UBIEEE/FrankenMouse/hardware/mouse_v3/cad/README.md

# MicroMouse v3 CAD

Version 3 CAD files are hosted on OnShape [here](https://cad.onshape.com/documents/af6c3d153a48b04e15596561/w/45876cc96303d29a7562e9dc/e/812e529ec357d4b21b92344f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)
