UBIEEE/FrankenMouse/hardware/mouse_v2/cad/README.md

# MicroMouse v2 CAD

Version 2 CAD files are hosted on OnShape [here](https://cad.onshape.com/documents/abafea81b596ad090b5c0efe/w/ced7ecb2f8934ecdedd5f346/e/1f72ba2e5dd2ff6e9ada31ef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)
