UBIEEE/FrankenMouse/media/mouse_v3/top_portrait.jpeg

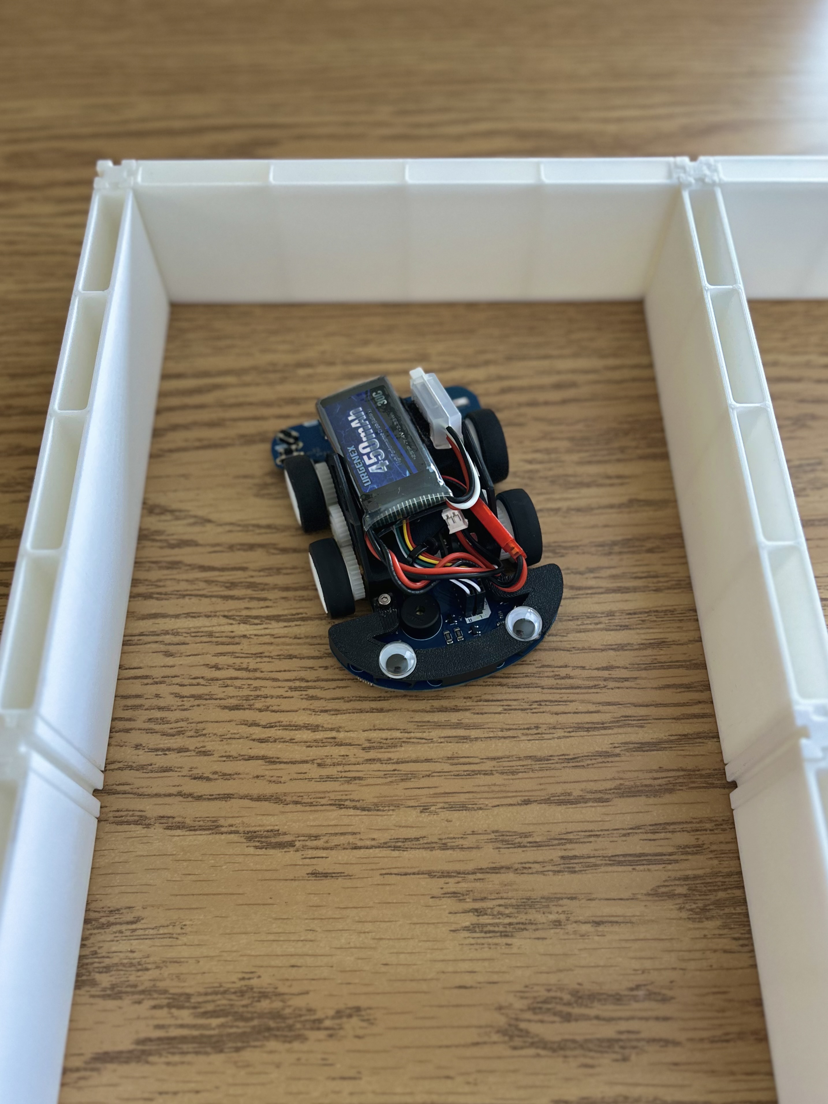
media/mouse_v3/top_portrait.jpeg
