UBIEEE/FrankenMouse/hardware/mouse_v3/pcb/micromouse.kicad_pcb

## KiCad design hardware/mouse_v3/pcb/micromouse.kicad_pcb (2025-03-24)

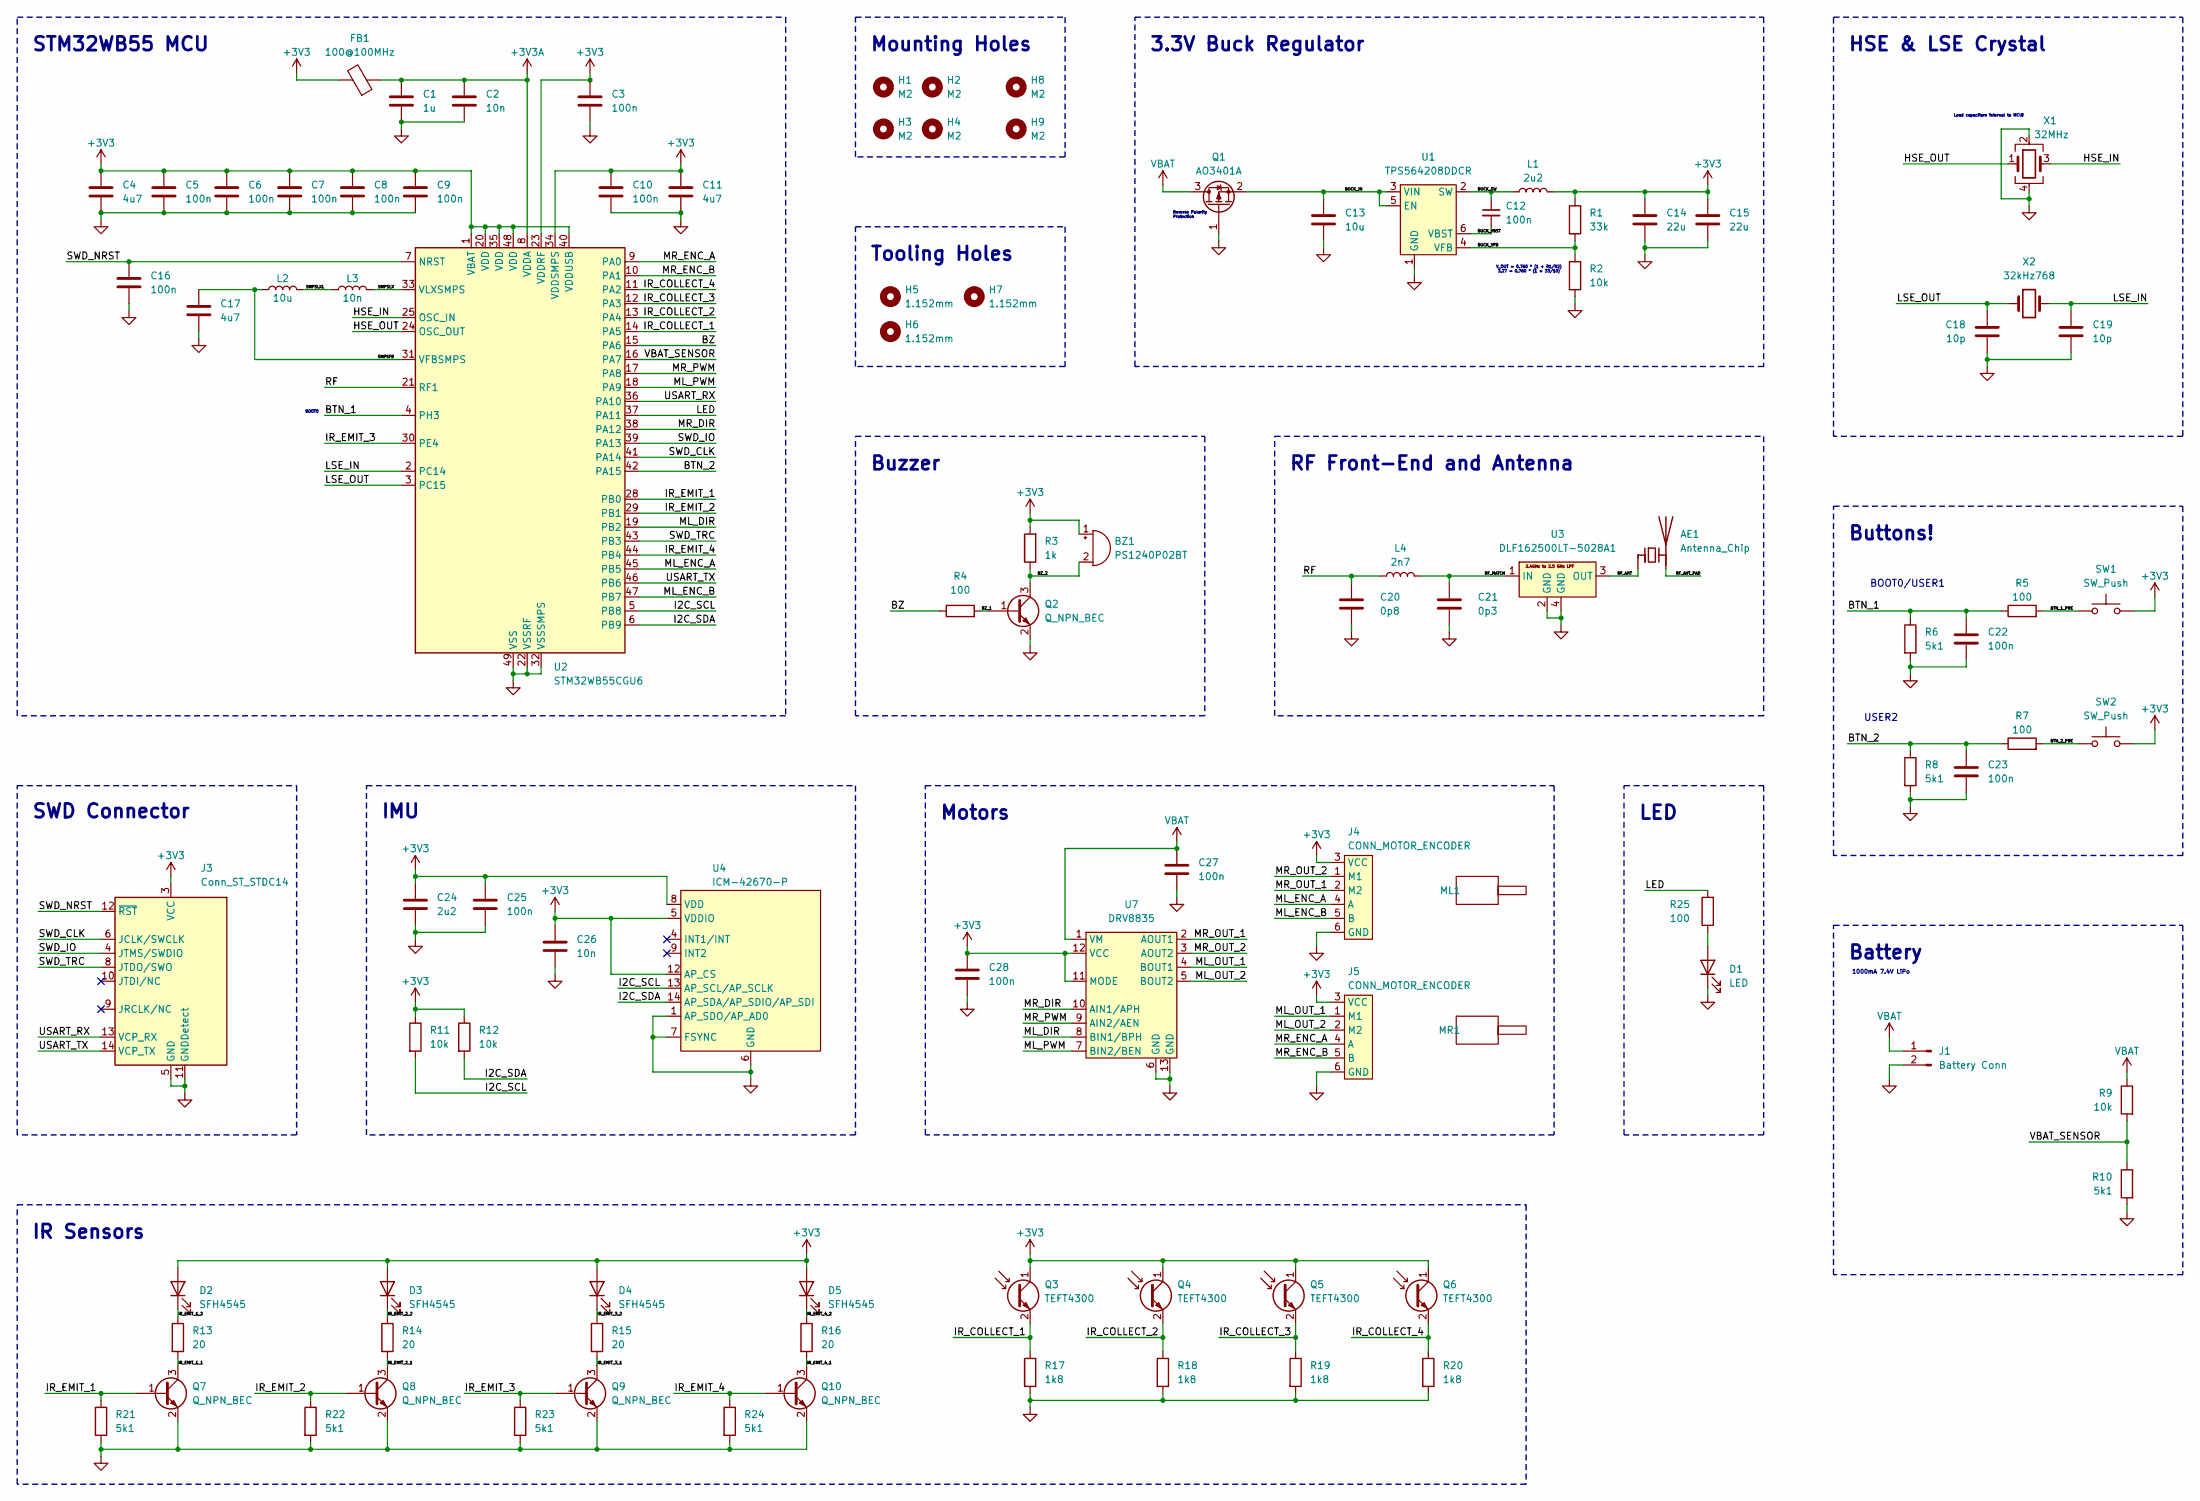
[picture p7: schematic micromouse.kicad_sch]

Parts:
AE1: Antenna_Chip; ANT_2450AT42A100E
BZ1: PS1240P02BT
C1: 1u; C_0603_1608Metric; LCSC Part C15849
C2, C26: 10n; C_0402_1005Metric; LCSC Part C15195
C3, C5, C6, C7, C8, C9, C10, C12, C16, C22, C23, C25, C27, C28: 100n; C_0402_1005Metric; LCSC Part C307331
C4, C11, C17: 4u7; C_0603_1608Metric; LCSC Part C19666
C13: 10u; C_1206_3216Metric; LCSC Part C13585
C14, C15: 22u; C_0805_2012Metric; LCSC Part C45783
C18, C19: 10p; C_0402_1005Metric; LCSC Part C32949
C20: 0p8; C_0402_1005Metric; LCSC Part C76915
C21: 0p3; C_0402_1005Metric; LCSC Part C92338
C24: 2u2; C_0603_1608Metric; LCSC Part C23630
D1: LED; D_0603_1608Metric; LCSC Part C2286
D2, D4: SFH4545; SFH4545_FLIPPED
D3, D5: SFH4545
FB1: 100@100MHz; D_0805_2012Metric; LCSC Part C1015
H1, H2, H3, H4, H8, H9: M2; MountingHole_2.2mm_M2
H5, H6, H7: 1.152mm; JLC_TOOLING_HOLE
J1: Battery Conn; CONN_BATTERY
J3: Conn_ST_STDC14; SAMTEC_FTSH-107-01-L-DV-K-A
J4, J5: CONN_MOTOR_ENCODER; PinHeader_1x06_P2.00mm_Vertical
L1: 2u2; L_0805_2012Metric; LCSC Part C383369
L2: 10u; L_0805_2012Metric; LCSC Part C1046
L3: 10n; L_0402_1005Metric; LCSC Part C77103
L4: 2n7; L_0402_1005Metric; LCSC Part C77108
ML1: MOTOR_N20
MR1: MOTOR_N20
Q1: AO3401A; SOT-23; LCSC Part C15127
Q2, Q7, Q8, Q9, Q10: Q_NPN_BEC; SOT-23; LCSC Part C2150
Q3, Q5: TEFT4300
Q4, Q6: TEFT4300; TEFT4300_FLIPPED
R1: 33k; R_0402_1005Metric; LCSC Part C25779
R2, R9, R11, R12: 10k; R_0402_1005Metric; LCSC Part C25744
R3: 1k; R_0402_1005Metric; LCSC Part C11702
R4, R5, R7, R25: 100; R_0402_1005Metric; LCSC Part C25076
R6, R8, R10, R21, R22, R23, R24: 5k1; R_0402_1005Metric; LCSC Part C25905
R13, R14, R15, R16: 20; R_1206_3216Metric; LCSC Part C17955
R17, R18, R19, R20: 1k8; R_0603_1608Metric; LCSC Part C4177
SW1, SW2: SW_Push; SW_PUSH_1P1T_6x3.5mm_H5.0_APEM_MJTP1250
U1: TPS564208DDCR; TSOT-23-6; LCSC Part C486062
U2: STM32WB55CGU6; QFN-48-1EP_7x7mm_P0.5mm_EP5.6x5.6mm; LCSC Part C404023
U3: DLF162500LT-5028A1; LCSC Part C531364
U4: ICM-42670-P; LCSC Part C3288646
U7: DRV8835; DSS0012A; LCSC Part C129328
X1: 32MHz; XL7EL89CKI-111YLC-32M; LCSC Part C2965582
X2: 32kHz768; Crystal_SMD_3215-2Pin_3.2x1.5mm; LCSC Part C32346

Connections:
+3V3: BZ1.1 (+), C3.1, C4.1, C5.1, C6.1, C7.1, C8.1, C9.1, C10.1, C11.1, C14.1, C15.1, C24.1, C25.1, C26.1, C28.1, D2.2 (A), D3.2 (A), D4.2 (A), D5.2 (A), FB1.2, J3.3 (VCC), J4.3 (VCC), J5.3 (VCC), L1.2, Q3.1 (C), Q4.1 (C), Q5.1 (C), Q6.1 (C), R1.1, R3.2, R11.1, R12.1, SW1.2, SW2.2, U2.1 (VBAT), U2.20 (VDD), U2.23 (VDDRF), U2.34 (VDDSMPS), U2.35 (VDD), U2.40 (VDDUSB), U2.48 (VDD), U4.5 (VDDIO), U4.8 (VDD), U4.12 (AP_CS), U7.11 (MODE), U7.12 (VCC)
+3V3A: C1.1, C2.1, FB1.1, U2.8 (VDDA)
/BTN_1: C22.1, R5.1, R6.1, U2.4 (PH3)
/BTN_1_PRE: R5.2, SW1.1
/BTN_2: C23.1, R7.1, R8.1, U2.42 (PA15)
/BTN_2_PRE: R7.2, SW2.1
/BUCK_IN: C13.1, Q1.2 (S), U1.3 (VIN), U1.5 (EN)
/BUCK_SW: C12.1, L1.1, U1.2 (SW)
/BUCK_VBST: C12.2, U1.6 (VBST)
/BUCK_VFB: R1.2, R2.1, U1.4 (VFB)
/BZ: R4.1, U2.15 (PA6)
/BZ_1: Q2.1 (B), R4.2
/BZ_2: BZ1.2 (-), Q2.3 (C), R3.1
/HSE_IN: U2.25 (OSC_IN), X1.3
/HSE_OUT: U2.24 (OSC_OUT), X1.1
/I2C_SCL: R11.2, U2.5 (PB8), U4.13 (AP_SCL/AP_SCLK)
/I2C_SDA: R12.2, U2.6 (PB9), U4.14 (AP_SDA/AP_SDIO/AP_SDI)
/IR_COLLECT_1: Q3.2 (E), R17.1, U2.14 (PA5)
/IR_COLLECT_2: Q4.2 (E), R18.1, U2.13 (PA4)
/IR_COLLECT_3: Q5.2 (E), R19.1, U2.12 (PA3)
/IR_COLLECT_4: Q6.2 (E), R20.1, U2.11 (PA2)
/IR_EMIT_1: Q7.1 (B), R21.1, U2.28 (PB0)
/IR_EMIT_1_1: Q7.3 (C), R13.2
/IR_EMIT_1_2: D2.1 (K), R13.1
/IR_EMIT_2: Q8.1 (B), R22.1, U2.29 (PB1)
/IR_EMIT_2_1: Q8.3 (C), R14.2
/IR_EMIT_2_2: D3.1 (K), R14.1
/IR_EMIT_3: Q9.1 (B), R23.1, U2.30 (PE4)
/IR_EMIT_3_1: Q9.3 (C), R15.2
/IR_EMIT_3_2: D4.1 (K), R15.1
/IR_EMIT_4: Q10.1 (B), R24.1, U2.44 (PB4)
/IR_EMIT_4_1: Q10.3 (C), R16.2
/IR_EMIT_4_2: D5.1 (K), R16.1
/LED: R25.2, U2.37 (PA11)
/LSE_IN: C19.1, U2.2 (PC14), X2.2
/LSE_OUT: C18.1, U2.3 (PC15), X2.1
/ML_DIR: U2.19 (PB2), U7.8 (BIN1/BPH)
/ML_ENC_A: J4.4 (A), U2.45 (PB5)
/ML_ENC_B: J4.5 (B), U2.47 (PB7)
/ML_OUT_1: J5.1 (M1), U7.4 (BOUT1)
/ML_OUT_2: J5.2 (M2), U7.5 (BOUT2)
/ML_PWM: U2.18 (PA9), U7.7 (BIN2/BEN)
/MR_DIR: U2.38 (PA12), U7.10 (AIN1/APH)
/MR_ENC_A: J5.4 (A), U2.9 (PA0)
/MR_ENC_B: J5.5 (B), U2.10 (PA1)
/MR_OUT_1: J4.2 (M2), U7.2 (AOUT1)
/MR_OUT_2: J4.1 (M1), U7.3 (AOUT2)
/MR_PWM: U2.17 (PA8), U7.9 (AIN2/AEN)
/RF: C20.1, L4.2, U2.21 (RF1)
/RF_ANT: AE1.1 (FEED), U3.3 (OUT)
/RF_ANT_PAD: AE1.2 (PCB_Trace)
/RF_MATCH: C21.1, L4.1, U3.1 (IN)
/SMPSFB: C17.1, L2.1, U2.31 (VFBSMPS)
/SMPSLX: L3.2, U2.33 (VLXSMPS)
/SMPSLXL: L2.2, L3.1
/SWD_CLK: J3.6 (JCLK/SWCLK), U2.41 (PA14)
/SWD_IO: J3.4 (JTMS/SWDIO), U2.39 (PA13)
/SWD_NRST: C16.1, J3.12 (~RST), U2.7 (NRST)
/SWD_TRC: J3.8 (JTDO/SWO), U2.43 (PB3)
/USART_RX: J3.13 (VCP_RX), U2.36 (PA10)
/USART_TX: J3.14 (VCP_TX), U2.46 (PB6)
/VBAT_SENSOR: R9.2, R10.1, U2.16 (PA7)
GND: C1.2, C2.2, C3.2, C4.2, C5.2, C6.2, C7.2, C8.2, C9.2, C10.2, C11.2, C13.2, C14.2, C15.2, C16.2, C17.2, C18.2, C19.2, C20.2, C21.2, C22.2, C23.2, C24.2, C25.2, C26.2, C27.2, C28.2, D1.1 (K), J1.2, J3.5 (GND), J3.7 (GND), J3.11 (GNDDetect), J4.6 (GND), J5.6 (GND), Q1.1 (G), Q2.2 (E), Q7.2 (E), Q8.2 (E), Q9.2 (E), Q10.2 (E), R2.2, R6.2, R8.2, R10.2, R17.2, R18.2, R19.2, R20.2, R21.2, R22.2, R23.2, R24.2, U1.1 (GND), U2.22 (VSSRF), U2.32 (VSSSMPS), U2.49 (VSS), U3.2 (GND), U3.4 (GND), U4.1 (AP_SDO/AP_AD0), U4.6 (GND), U4.7 (FSYNC), U7.6 (GND), U7.13 (GND), X1.2, X1.4
unnamed: D1.2 (A), R25.1
VBAT: C27.1, J1.1, Q1.3 (D), R9.1, U7.1 (VM)

Notes on the sheet:
Buzzer
SWD Connector
BOOT0/USER1
Tooling Holes
RF Front-End and Antenna
IR Sensors
Buttons!
Reverse Polarity Protection
STM32WB55 MCU
LED
V_OUT = 0.760 * (1 + R1/R2) 3.27 = 0.760 * (1 + 33/10)
HSE & LSE Crystal
IMU
3.3V Buck Regulator
1000mA 7.4V LiPo
Motors
Mounting Holes
Battery
USER2
BOOT0
Load capacitors internal to MCU!

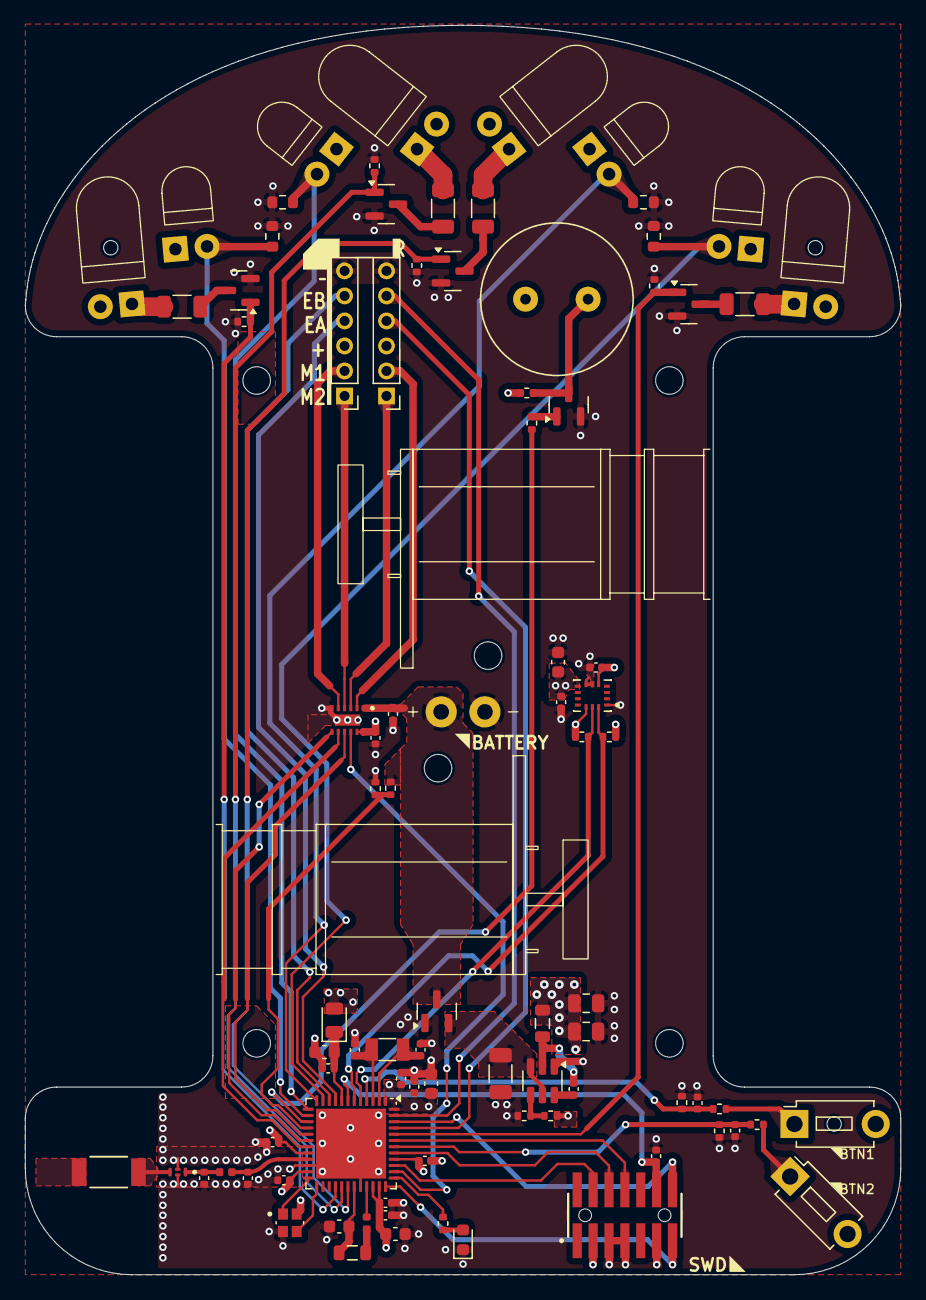
[picture p8: board micromouse.kicad_pcb from above]

Board: 4 copper layers, 70.0 x 99.9 mm, 99 parts (0 on the bottom side), 64 nets.
