UBIEEE/FrankenMouse/firmware/platform/mouse_v3/Core/Src/main.c

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
/* Includes ------------------------------------------------------------------*/
#include "main.h"

/* USER CODE BEGIN Includes */

#include <micromouse/robot/robot.h>

/* USER CODE END Includes */

ADC_HandleTypeDef hadc1;
DMA_HandleTypeDef hdma_adc1;

I2C_HandleTypeDef hi2c1;
DMA_HandleTypeDef hdma_i2c1_rx;

IPCC_HandleTypeDef hipcc;

LPTIM_HandleTypeDef hlptim1;

RTC_HandleTypeDef hrtc;

TIM_HandleTypeDef htim1;
TIM_HandleTypeDef htim2;
TIM_HandleTypeDef htim16;

UART_HandleTypeDef huart1;

void SystemClock_Config(void);
void PeriphCommonClock_Config(void);
static void MX_GPIO_Init(void);
static void MX_DMA_Init(void);
static void MX_TIM16_Init(void);
static void MX_TIM2_Init(void);
static void MX_LPTIM1_Init(void);
static void MX_I2C1_Init(void);
static void MX_IPCC_Init(void);
static void MX_RTC_Init(void);
static void MX_ADC1_Init(void);
static void MX_TIM1_Init(void);
static void MX_USART1_UART_Init(void);
static void MX_RF_Init(void);
/**
  * @brief  The application entry point.
  * @retval int
  */
int main(void)
{

  /* MCU Configuration--------------------------------------------------------*/

  /* Reset of all peripherals, Initializes the Flash interface and the Systick. */
  HAL_Init();
  /* Config code for STM32_WPAN (HSE Tuning must be done before system clock configuration) */
  MX_APPE_Config();

  /* Configure the system clock */
  SystemClock_Config();

/* Configure the peripherals common clocks */
  PeriphCommonClock_Config();

  /* IPCC initialisation */
  MX_IPCC_Init();

  /* Initialize all configured peripherals */
  MX_GPIO_Init();
  MX_DMA_Init();
  MX_TIM16_Init();
  MX_TIM2_Init();
  MX_LPTIM1_Init();
  MX_I2C1_Init();
  MX_RTC_Init();
  MX_ADC1_Init();
  MX_TIM1_Init();
  MX_USART1_UART_Init();
  MX_RF_Init();
  /* USER CODE BEGIN 2 */

  HAL_TIM_PWM_Start(&htim1, TIM_CHANNEL_1); // Left Motor
  HAL_TIM_PWM_Start(&htim1, TIM_CHANNEL_2); // Right Motor

  HAL_TIM_Encoder_Start(&htim2, TIM_CHANNEL_ALL); // Encoder Right
  HAL_LPTIM_Encoder_Start(&hlptim1, 0xFFFF); // Encoder Left

  HAL_TIM_PWM_Start(&htim16, TIM_CHANNEL_1); // Buzzer

  /* USER CODE END 2 */

  /* Init code for STM32_WPAN */
  MX_APPE_Init();

  /* Infinite loop */
  /* USER CODE BEGIN WHILE */
  while (1)
  {
    /* USER CODE END WHILE */
    MX_APPE_Process();

    /* USER CODE BEGIN 3 */
  }
  /* USER CODE END 3 */
}

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
