UBIEEE/FrankenMouse/firmware/platform/mouse_v3/Core/Src/hardware/encoder.cpp

#include "hardware/encoder.hpp"

#include <micromouse/robot/robot.h>
#include "main.h"

#include <cmath>
#include <numbers>

//
// Constants.
//

// Encoder constants.
static constexpr int8_t ENCODER_MAGNET_POLES = 6;
static constexpr float GEAR_RATIO = 20.f;
static constexpr float ENCODER_TICKS_PER_ROTATION = (ENCODER_MAGNET_POLES * GEAR_RATIO);

static constexpr units::millimeter_t WHEEL_DIAMETER = 25_mm;
static constexpr units::millimeter_t WHEEL_CIRCUMFERENCE = (WHEEL_DIAMETER * std::numbers::pi_v<float>);

// static constexpr auto ENCODER_TICKS_PER_DISTANCE = (ENCODER_TICKS_PER_ROTATION / WHEEL_CIRCUMFERENCE);
// static constexpr units::millimeter_t ENCODER_DISTANCE_PER_TICK = (1.f / ENCODER_TICKS_PER_DISTANCE);

static constexpr auto ENCODER_TICKS_PER_DISTANCE = (336.f / 200_mm);  // We measured 320 ticks in 200 mm
static constexpr units::millimeter_t ENCODER_DISTANCE_PER_TICK = (1.f / ENCODER_TICKS_PER_DISTANCE);

//
// Encoder functions.
//

hardware::Drivetrain::EncoderData Encoder::update(uint16_t ticks) {
  const int32_t delta_ticks = calc_delta_ticks(ticks, m_last_ticks);

  m_last_ticks = ticks;
  m_ticks += delta_ticks;

  /**
   * Simple low-pass filter to smooth velocity estimates, since we usually only get a tick every few
   * iterations.
   */

  float instant_velocity = delta_ticks / ROBOT_UPDATE_PERIOD_S;

  static constexpr units::second_t tau = 0.01_s;  // Time constant for velocity smoothing, tune as necessary
  static constexpr float alpha = ROBOT_UPDATE_PERIOD / (tau + ROBOT_UPDATE_PERIOD);

  m_velocity = alpha * instant_velocity + (1.f - alpha) * m_velocity;

  return {.position = m_ticks * ENCODER_DISTANCE_PER_TICK,
          .velocity = (m_velocity / 1_s) * ENCODER_DISTANCE_PER_TICK,
          .ticks = static_cast<int32_t>(m_ticks)};
}

int32_t Encoder::calc_delta_ticks(uint16_t current, uint16_t last) {
  int32_t delta_ticks = current - last;

  const bool signbit = std::signbit(delta_ticks);

  const int32_t abs_delta_ticks = signbit ? -delta_ticks : delta_ticks;

  // If the delta is big, there must have been an overflow.
  if (abs_delta_ticks > INT16_MAX) {
    // Add 0xFFFF when deep negative, subtract when positive.
    delta_ticks += UINT16_MAX * (signbit ? 1 : -1);
  }

  return delta_ticks;
}
