UBIEEE/FrankenMouse/firmware/platform/mouse_v3/Core/Src/stm32wbxx_it.c

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

/* Includes ------------------------------------------------------------------*/
#include "main.h"
#include "stm32wbxx_it.h"
/* USER CODE BEGIN Includes */

#include <stdbool.h>
#include "stm32_seq.h"
#include <micromouse/robot/robot.h>

/* USER CODE END Includes */

/* USER CODE BEGIN PV */

extern bool g_robot_tasks_registered; // custom_app.c

/* USER CODE END PV */

/* External variables --------------------------------------------------------*/
extern DMA_HandleTypeDef hdma_adc1;
extern DMA_HandleTypeDef hdma_i2c1_rx;
extern I2C_HandleTypeDef hi2c1;
extern IPCC_HandleTypeDef hipcc;
extern RTC_HandleTypeDef hrtc;
extern TIM_HandleTypeDef htim1;
/******************************************************************************/
/*           Cortex Processor Interruption and Exception Handlers          */
/******************************************************************************/
/**
  * @brief This function handles Non maskable interrupt.
  */
void NMI_Handler(void)
{
  /* USER CODE BEGIN NonMaskableInt_IRQn 1 */
   while (1)
  {
  }
  /* USER CODE END NonMaskableInt_IRQn 1 */
}

/**
  * @brief This function handles Hard fault interrupt.
  */
void HardFault_Handler(void)
{
  while (1)
  {
  }
}

/**
  * @brief This function handles Memory management fault.
  */
void MemManage_Handler(void)
{
  while (1)
  {
  }
}

/**
  * @brief This function handles Prefetch fault, memory access fault.
  */
void BusFault_Handler(void)
{
  while (1)
  {
  }
}

/**
  * @brief This function handles Undefined instruction or illegal state.
  */
void UsageFault_Handler(void)
{
  while (1)
  {
  }
}

/**
  * @brief This function handles System service call via SWI instruction.
  */
void SVC_Handler(void)
{
}

/**
  * @brief This function handles Debug monitor.
  */
void DebugMon_Handler(void)
{
}

/**
  * @brief This function handles Pendable request for system service.
  */
void PendSV_Handler(void)
{
}

/**
  * @brief This function handles System tick timer.
  */
void SysTick_Handler(void)
{
  HAL_IncTick();
  /* USER CODE BEGIN SysTick_IRQn 1 */

  // Make sure the tasks are registered with the sequencer before telling the
  // sequencer to run the tasks!
  if (!g_robot_tasks_registered) return;

  const uint32_t ticks = HAL_GetTick();

  // Tell the sequencer to run the main robot task every tick.
  if (ticks % ROBOT_UPDATE_PERIOD_MS == 0) {
    UTIL_SEQ_SetTask(1 << CFG_TASK_ROBOT_PERIODIC_ID, CFG_SCH_PRIO_0);
  }

  // Tell the sequencer to run the send feedback robot task less often.
  if (ticks % ROBOT_PUBLISH_FEEDBACK_PERIOD_MS == 0) {
    UTIL_SEQ_SetTask(1 << CFG_TASK_ROBOT_SEND_FEEDBACK_ID, CFG_SCH_PRIO_0);
  }

  /* USER CODE END SysTick_IRQn 1 */
}

/******************************************************************************/
/* STM32WBxx Peripheral Interrupt Handlers                                    */
/* Add here the Interrupt Handlers for the used peripherals.                  */
/* For the available peripheral interrupt handler names,                      */
/* please refer to the startup file (startup_stm32wbxx.s).                    */
/******************************************************************************/

/**
  * @brief This function handles RTC wake-up interrupt through EXTI line 19.
  */
void RTC_WKUP_IRQHandler(void)
{
  HAL_RTCEx_WakeUpTimerIRQHandler(&hrtc);
}

/**
  * @brief This function handles EXTI line3 interrupt.
  */
void EXTI3_IRQHandler(void)
{
  HAL_GPIO_EXTI_IRQHandler(BUTTON_1_Pin);
}

/**
  * @brief This function handles DMA1 channel1 global interrupt.
  */
void DMA1_Channel1_IRQHandler(void)
{
  HAL_DMA_IRQHandler(&hdma_i2c1_rx);
}

/**
  * @brief This function handles DMA1 channel2 global interrupt.
  */
void DMA1_Channel2_IRQHandler(void)
{
  HAL_DMA_IRQHandler(&hdma_adc1);
}

/**
  * @brief This function handles TIM1 trigger and commutation interrupts and TIM17 global interrupt.
  */
void TIM1_TRG_COM_TIM17_IRQHandler(void)
{
  HAL_TIM_IRQHandler(&htim1);
}

/**
  * @brief This function handles I2C1 event interrupt.
  */
void I2C1_EV_IRQHandler(void)
{
  HAL_I2C_EV_IRQHandler(&hi2c1);
}

/**
  * @brief This function handles I2C1 error interrupt.
  */
void I2C1_ER_IRQHandler(void)
{
  HAL_I2C_ER_IRQHandler(&hi2c1);
}

/**
  * @brief This function handles EXTI line[15:10] interrupts.
  */
void EXTI15_10_IRQHandler(void)
{
  HAL_GPIO_EXTI_IRQHandler(BUTTON_2_Pin);
}

/**
  * @brief This function handles IPCC RX occupied interrupt.
  */
void IPCC_C1_RX_IRQHandler(void)
{
  HAL_IPCC_RX_IRQHandler(&hipcc);
}

/**
  * @brief This function handles IPCC TX free interrupt.
  */
void IPCC_C1_TX_IRQHandler(void)
{
  HAL_IPCC_TX_IRQHandler(&hipcc);
}

/**
  * @brief This function handles HSEM global interrupt.
  */
void HSEM_IRQHandler(void)
{
  HAL_HSEM_IRQHandler();
}
