UBIEEE/FrankenMouse/firmware/platform/simulation/src/hardware/measurements_impl.cpp

#include <micromouse/hardware/measurements.hpp>

using namespace hardware;

RobotMeasurements& get_robot_measurements() {
  // Same as v3.
  static RobotMeasurements measurements = {
      .length = 100_mm,
      .width = 70_mm,
      .center_to_front = 55_mm,
      .center_to_back = 45_mm,
      .track_width = 50.4_mm,
      .mid_ir_sensor_angle = 52_deg,
      .far_ir_sensor_angle = 5_deg,
  };

  return measurements;
}
