UBIEEE/FrankenMouse/(commit log)

2025-03-22 A couple changes...
    Restructured firmware: split into platform-independent logic library and platform-specific hardware code. Created 3D simulation in Godot with ROS2, added ROS2 target to dashboard, and lots more.
    [micromouse.kicad_pcb, micromouse.kicad_sch]
2025-03-24 V3 PCB and CAD
    [micromouse.kicad_pcb, micromouse.kicad_sch]
2025-03-24 Created STM32CubeMX project for V3
2025-03-27 Mouse v2 Buttons
2025-04-29 Invert left motor direction
    [drivetrain_impl.cpp]
2025-04-29 Fixed silly typos in Feedback implementations
    [feedback_impl.cpp, feedback_impl.hpp]
2025-05-09 Thread-safe status, warning, and error message reporting
    [diagnostics.cpp]
2025-05-09 Fixed crash on empty prompt invocation
    [prompt.cpp]
2025-05-10 Added ChassisSpeeds struct, converted TI-84 serial message to chassis speeds, updated display function
2025-05-13 Added chassis speeds BLE characteristic
2025-05-13 Added manual control chassis speeds task
2026-02-15 [cli] Created drive-pid-get and drive-pid-set commands
2026-02-15 [cli] Forgot to spin the ros2 node, fixed it now
    [main.cpp]
2026-02-16 [firmware] Switched units library default data type to float
2026-03-01 [cli] Send Drive PID values to -1 when not set
2026-03-01 [app] Default Drive PID values to -1
2026-03-05 [firmware] Increase v3 track width measurement for added gears
2026-03-05 [firmware] Fix simulation feedback subscribers+publishers
    [feedback_impl.cpp, feedback_impl.hpp]
2026-03-05 [firmware] STM32 VS Code Extension update changed some settings
2026-03-09 [app] Added idle task and displayed encoder ticks on drive page
2026-03-09 [cli] Added idle task and updated motor data topic
2026-03-09 [firmware] Implemented v3 ADC code for IR sensors and battery voltage reading, sent battery voltage feedback
2026-03-09 [cli] Receive battery voltage feedback topic
2026-03-09 [app] Receive battery voltage feedback
2026-03-12 [firmware] The IR sensors were reversed!
2026-03-12 [simulation] Flip order of IR sensors array to match what robot expects
2026-03-12 [firmware] Reduced size of drive data BLE characteristic to be correct and get rid of warnings from the clients
    [micromouse.ioc]
2026-03-12 [firmware] Remove all of the STM32 VSCode Extension generated files, updated build instructions to include setup instructions
2026-03-18 [firmware] Stop running current task when BLE disconnects
2026-03-18 [firmware] Zero IMU readings when entering standby mode
2026-03-18 [firmware] Wait some time after taking IMU off standby mode to read data
2026-03-18 [firmware] Keep track of whether each direction of a cell has been seen instead of whether we have visited that cell
2026-03-20 [app] Display battery voltage on main page
2026-03-20 [firmware] Added get voltage method to battery class
2026-03-20 [firmware] Median filter class
2026-03-20 [firmware] Filter IMU gyro readings with median filter
2026-03-20 [firmware] Send time of errors
    [timer_impl.cpp]
2026-03-21 [firmware] Low pass filter on encoders to calculate better velocity
2026-03-21 [firmware] Adjust drive speeds based on battery voltage, add raw speed control function
2026-03-21 [firmware] Errors and status stuff
    [ir_sensors_and_battery_impl.cpp, ir_sensors_and_battery_impl.hpp]
