UBIEEE/FrankenMouse/(notices)

Notices in the files:
firmware/platform/mouse_v3/Core/Src/app_debug.c:
Copyright (c) 2025 STMicroelectronics.
All rights reserved.
This software is licensed under terms that can be found in the LICENSE file
